ELEC-291-Dream-Team/Project-2-Tracking-Robot/doc/robot diagram/robot diagram.png

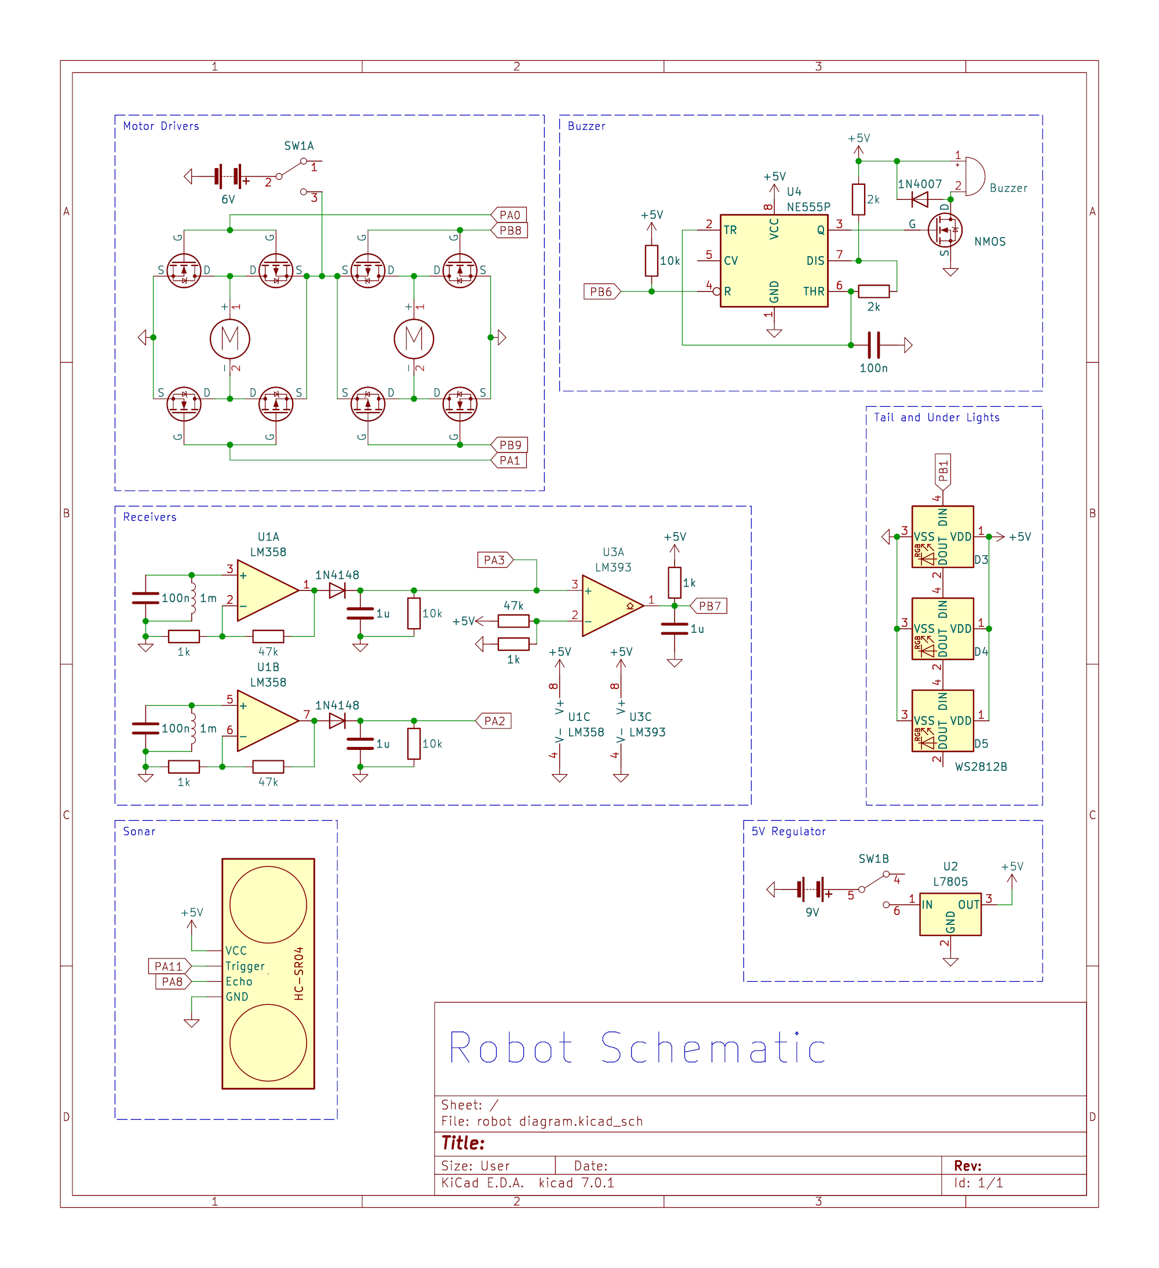
doc/robot diagram/robot diagram.png
