ELEC-291-Dream-Team/Project-2-Tracking-Robot/doc/robot diagram/robot diagram.kicad_pcb

## KiCad design hw/lux_meter.kicad_sch

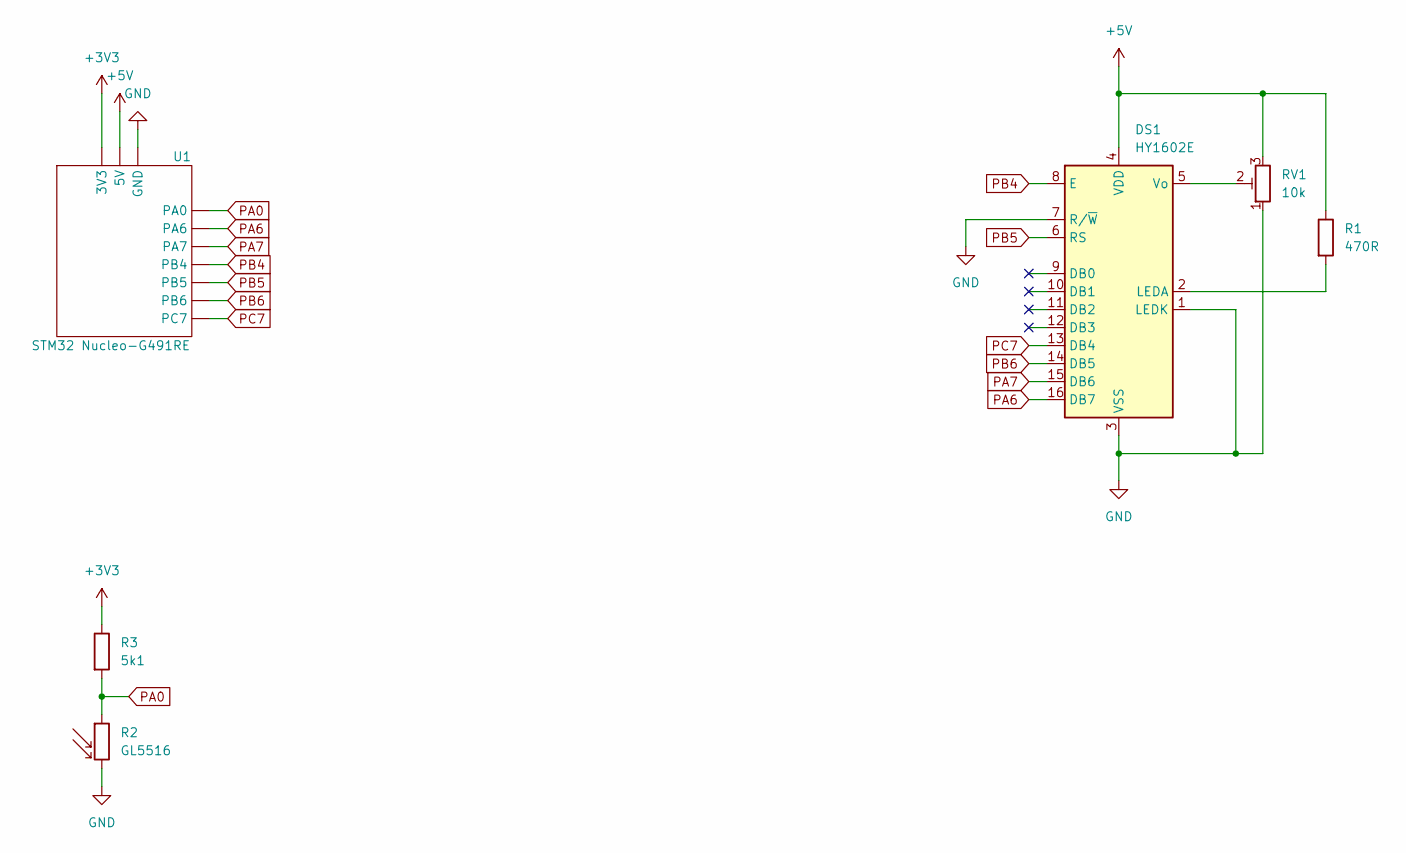
[picture p2: schematic lux_meter.kicad_sch]

Parts:
DS1: HY1602E
R1: 470R
R2: GL5516; R_LDR_5.1x4.3mm_P3.4mm_Vertical
R3: 5k1
RV1: 10k
U1: STM32 Nucleo-G491RE

Connections:
+3V3: R3.1, U1.
+5V: DS1.4 (VDD), R1.1, RV1.3, U1.
GND: DS1.1 (LEDK), DS1.3 (VSS), DS1.7 (R/~W), R2.2, RV1.1, U1.
unnamed: DS1.2 (LEDA), R1.2
unnamed: DS1.5 (Vo), RV1.2
PA0: R2.1, R3.2, U1.
PA6: DS1.16 (DB7), U1.
PA7: DS1.15 (DB6), U1.
PB4: DS1.8 (E), U1.
PB5: DS1.6 (RS), U1.
PB6: DS1.14 (DB5), U1.
PC7: DS1.13 (DB4), U1.
