ELEC-291-Dream-Team/Project-2-Tracking-Robot/src/robot/Core/Inc/main.h

#define LED_BUILTIN_Pin GPIO_PIN_13
#define LED_BUILTIN_GPIO_Port GPIOC
#define LEFT_MOTOR_B_Pin GPIO_PIN_0
#define LEFT_MOTOR_B_GPIO_Port GPIOA
#define LEFT_MOTOR_A_Pin GPIO_PIN_1
#define LEFT_MOTOR_A_GPIO_Port GPIOA
#define RIGHT_ADC_Pin GPIO_PIN_2
#define RIGHT_ADC_GPIO_Port GPIOA
#define LEFT_ADC_Pin GPIO_PIN_3
#define LEFT_ADC_GPIO_Port GPIOA
#define WS2812_PIN_Pin GPIO_PIN_1
#define WS2812_PIN_GPIO_Port GPIOB
#define SONAR_ECHO_Pin GPIO_PIN_8
#define SONAR_ECHO_GPIO_Port GPIOA
#define SONAR_TRIGGER_Pin GPIO_PIN_11
#define SONAR_TRIGGER_GPIO_Port GPIOA
#define BUZZER_PIN_Pin GPIO_PIN_6
#define BUZZER_PIN_GPIO_Port GPIOB
#define PULSE_IN_Pin GPIO_PIN_7
#define PULSE_IN_GPIO_Port GPIOB
#define RIGHT_MOTOR_B_Pin GPIO_PIN_8
#define RIGHT_MOTOR_B_GPIO_Port GPIOB
#define RIGHT_MOTOR_A_Pin GPIO_PIN_9
#define RIGHT_MOTOR_A_GPIO_Port GPIOB
#define TARGETADCLEFT 700
#define TARGETADCRIGHT 1050
#define DEADZONE 150
#define WS2812_HIGH_BIT 60
#define WS2812_LOW_BIT 30
#define LED_COUNT 3
#define LEFTADC ADCBuffer[0]
#define RIGHTADC ADCBuffer[1]
