ELEC-291-Dream-Team/Project-2-Tracking-Robot/src/robot/Core/Src/main.c

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
/* Includes ------------------------------------------------------------------*/
#include "main.h"

/* USER CODE BEGIN Includes */
#include <stdio.h>
#include <string.h>
#include <math.h>

/* USER CODE END Includes */

/* USER CODE BEGIN PD */
#define DEBUGGING
/* USER CODE END PD */

ADC_HandleTypeDef hadc1;
DMA_HandleTypeDef hdma_adc1;

TIM_HandleTypeDef htim1;
TIM_HandleTypeDef htim2;
TIM_HandleTypeDef htim3;
TIM_HandleTypeDef htim4;
DMA_HandleTypeDef hdma_tim3_ch4_up;

UART_HandleTypeDef huart1;

/* USER CODE BEGIN PV */
uint8_t WS2812Buffer[24 * LED_COUNT] = {0};
unsigned short LEDStep = 0;

uint16_t ADCBuffer[100];

char StringBuffer[100];

unsigned int TIM4LastFallingEdge;
unsigned int TIM4FallingEdge;
unsigned int ReceivedPeriodBuffer;
unsigned int ReceivedPeriod;

unsigned int SonarRisingEdge;
unsigned int SonarFallingEdge;
unsigned int SonarOverflowCount = 0;
long SonarPulse;
unsigned int SonarPulsePolarity = 1;

int Mode = 0; // 0 = track, 1 = controlled
/* USER CODE END PV */

void SystemClock_Config(void);
static void MX_GPIO_Init(void);
static void MX_DMA_Init(void);
static void MX_ADC1_Init(void);
static void MX_USART1_UART_Init(void);
static void MX_TIM4_Init(void);
static void MX_TIM3_Init(void);
static void MX_TIM1_Init(void);
static void MX_TIM2_Init(void);
/* USER CODE BEGIN PFP */
void SetColor(unsigned int index, unsigned short r, unsigned short g, unsigned short b);
void SetColorAll(unsigned short r, unsigned short g, unsigned short b);
void Rainbow(int length, float phase, float brightness);
void LeftMotor(int a, int b);
void RightMotor(int a, int b);
void SetTailLights(unsigned short r, unsigned short g, unsigned short b);
/* USER CODE END PFP */

/**
 * @brief  The application entry point.
 * @retval int
 */
int main(void)
{
    /* MCU Configuration--------------------------------------------------------*/

    /* Reset of all peripherals, Initializes the Flash interface and the Systick. */
    HAL_Init();

    /* Configure the system clock */
    SystemClock_Config();

    /* Initialize all configured peripherals */
    MX_GPIO_Init();
    MX_DMA_Init();
    MX_ADC1_Init();
    MX_USART1_UART_Init();
    MX_TIM4_Init();
    MX_TIM3_Init();
    MX_TIM1_Init();
    MX_TIM2_Init();
    /* USER CODE BEGIN 2 */
    HAL_ADC_Start_DMA(&hadc1, ADCBuffer, ARRAYLEN(ADCBuffer));

    LEFTSTOP();
    RIGHTSTOP();

    SetColorAll(0, 0, 0);

    sprintf(StringBuffer, "Start\r\n");
    HAL_UART_Transmit(&huart1, StringBuffer, strlen(StringBuffer), 10);
    /* USER CODE END 2 */

    /* Infinite loop */
    /* USER CODE BEGIN WHILE */
    while (1)
    {
        switch (Mode)
        {
        case 0: // tracking mode
            if (SonarPulse < 40)
            {
                HAL_GPIO_WritePin(BUZZER_PIN_GPIO_Port, BUZZER_PIN_Pin, 1);
            }
            else
            {
                HAL_GPIO_WritePin(BUZZER_PIN_GPIO_Port, BUZZER_PIN_Pin, 0);
            }
#ifdef DEBUGGING
            sprintf(StringBuffer, "Mode 0 ADC: %4d %4d Sonar: %d OV: %d\r\n", LEFTADC, RIGHTADC, SonarPulse, SonarOverflowCount);
            HAL_UART_Transmit(&huart1, StringBuffer, strlen(StringBuffer), 10);
            HAL_Delay(10);
#endif

            if (LEFTADC < TARGETADCLEFT - DEADZONE)
            {
                LEFTFORWARD();
            }
            else if (LEFTADC > TARGETADCLEFT + DEADZONE)
            {
                LEFTREVERSE();
            }
            else
            {
                LEFTSTOP();
            }

            if (RIGHTADC < TARGETADCRIGHT - DEADZONE)
            {
                RIGHTFORWARD();
            }
            else if (RIGHTADC > TARGETADCRIGHT + DEADZONE)
            {
                RIGHTREVERSE();
            }
            else
            {
                RIGHTSTOP();
            }
            break;
        case 1: // controlled mode
#ifdef DEBUGGING
            sprintf(StringBuffer, "Mode 1 PeriodB: %4d Period: %4d\r\n", ReceivedPeriodBuffer, ReceivedPeriod);
            HAL_UART_Transmit(&huart1, StringBuffer, strlen(StringBuffer), 10);
            HAL_Delay(10);
#endif
            ReceivedPeriod = ReceivedPeriodBuffer;
            if (COMPARE(ReceivedPeriod, 600, 25)) // forward
            {
                if (SonarPulse > 30)
                {
                    LEFTFORWARD();
                    RIGHTFORWARD();
                    SetTailLights(0, 0, 0);
                    HAL_GPIO_WritePin(BUZZER_PIN_GPIO_Port, BUZZER_PIN_Pin, 0);
                }
                else
                {
                    SetTailLights(30, 0, 0);
                    HAL_GPIO_WritePin(BUZZER_PIN_GPIO_Port, BUZZER_PIN_Pin, 1);
                }
            }
            else if (COMPARE(ReceivedPeriod, 650, 25)) // forward right
            {
                LEFTFORWARD();
                RIGHTSTOP();
                SetTailLights(0, 0, 0);
                HAL_GPIO_WritePin(BUZZER_PIN_GPIO_Port, BUZZER_PIN_Pin, 0);
            }
            else if (COMPARE(ReceivedPeriod, 700, 25)) // right
            {
                LEFTFORWARD();
                RIGHTREVERSE();
                SetTailLights(0, 0, 0);
                HAL_GPIO_WritePin(BUZZER_PIN_GPIO_Port, BUZZER_PIN_Pin, 0);
            }
            else if (COMPARE(ReceivedPeriod, 750, 25)) // reverse right
            {
                LEFTSTOP();
                RIGHTREVERSE();
                SetTailLights(10, 10, 10);
                HAL_GPIO_WritePin(BUZZER_PIN_GPIO_Port, BUZZER_PIN_Pin, 1);
            }
            else if (COMPARE(ReceivedPeriod, 800, 25)) // reverse
            {
                LEFTREVERSE();
                RIGHTREVERSE();
                SetTailLights(10, 10, 10);
                HAL_GPIO_WritePin(BUZZER_PIN_GPIO_Port, BUZZER_PIN_Pin, 1);
            }
            else if (COMPARE(ReceivedPeriod, 850, 25)) // reverse left
            {
                LEFTREVERSE();
                RIGHTSTOP();
                SetTailLights(10, 10, 10);
                HAL_GPIO_WritePin(BUZZER_PIN_GPIO_Port, BUZZER_PIN_Pin, 1);
            }
            else if (COMPARE(ReceivedPeriod, 900, 25)) // left
            {
                LEFTREVERSE();
                RIGHTFORWARD();
                SetTailLights(0, 0, 0);
                HAL_GPIO_WritePin(BUZZER_PIN_GPIO_Port, BUZZER_PIN_Pin, 0);
            }
            else if (COMPARE(ReceivedPeriod, 950, 25)) // forward left
            {
                LEFTSTOP();
                RIGHTFORWARD();
                SetTailLights(0, 0, 0);
                HAL_GPIO_WritePin(BUZZER_PIN_GPIO_Port, BUZZER_PIN_Pin, 0);
            }
            else // stop
            {
                LEFTSTOP();
                RIGHTSTOP();
                SetTailLights(30, 0, 0);
                HAL_GPIO_WritePin(BUZZER_PIN_GPIO_Port, BUZZER_PIN_Pin, 0);
            }
            break;
        default:
            break;
        }

        /* USER CODE END WHILE */

        /* USER CODE BEGIN 3 */
    }
    /* USER CODE END 3 */
}

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
/* USER CODE BEGIN 4 */

void SetColor(unsigned int index, unsigned short r, unsigned short g, unsigned short b)
{
    for (int mask = 0b10000000, i = 0; mask > 0; mask >>= 1, i++)
    {
        if (g & mask)
            WS2812Buffer[index * 24 + i] = WS2812_HIGH_BIT;
        else
            WS2812Buffer[index * 24 + i] = WS2812_LOW_BIT;
        if (r & mask)
            WS2812Buffer[index * 24 + 8 + i] = WS2812_HIGH_BIT;
        else
            WS2812Buffer[index * 24 + 8 + i] = WS2812_LOW_BIT;
        if (b & mask)
            WS2812Buffer[index * 24 + 16 + i] = WS2812_HIGH_BIT;
        else
            WS2812Buffer[index * 24 + 16 + i] = WS2812_LOW_BIT;
    }
}

void SetColorAll(unsigned short r, unsigned short g, unsigned short b)
{
    for (int i = 0; i < LED_COUNT; i++)
    {
        SetColor(i, r, g, b);
    }
}

void Rainbow(int length, float phase, float brightness)
{
    for (int i = 0; i < LED_COUNT; i++)
    {
        SetColor(i,
                 (unsigned short)(brightness * (cos(2 * M_PI * (phase + (float)i / length)) * 0xff + 0x7f)),
                 (unsigned short)(brightness * (cos(2 * M_PI * (phase + (float)i / length - 1.0 / 3)) * 0xff + 0x7f)),
                 (unsigned short)(brightness * (cos(2 * M_PI * (phase + (float)i / length - 2.0 / 3)) * 0xff + 0x7f)));
    }
}

void SetTailLights(unsigned short r, unsigned short g, unsigned short b)
{
    SetColor(0, r, g, b);
    SetColor(1, r, g, b);
}

void LeftMotor(int a, int b)
{
    HAL_GPIO_WritePin(LEFT_MOTOR_A_GPIO_Port, LEFT_MOTOR_A_Pin, a);
    HAL_GPIO_WritePin(LEFT_MOTOR_B_GPIO_Port, LEFT_MOTOR_B_Pin, b);
}

void RightMotor(int a, int b)
{
    HAL_GPIO_WritePin(RIGHT_MOTOR_A_GPIO_Port, RIGHT_MOTOR_A_Pin, a);
    HAL_GPIO_WritePin(RIGHT_MOTOR_B_GPIO_Port, RIGHT_MOTOR_B_Pin, b);
}

void HAL_TIM_PWM_PulseFinishedCallback(TIM_HandleTypeDef *htim)
{
    if (htim == &htim3)
    {
        __HAL_TIM_SetCompare(&htim3, TIM_CHANNEL_4, 0);
        HAL_TIM_PWM_Stop_DMA(&htim3, TIM_CHANNEL_4);
    }
}

void HAL_TIM_PeriodElapsedCallback(TIM_HandleTypeDef *htim)
{
    if (htim == &htim2)
    {
#ifdef DEBUGGING
        // sprintf(StringBuffer, "tim2 overflows\r\n");
        // HAL_UART_Transmit(&huart1, StringBuffer, strlen(StringBuffer), 10);
#endif
        if (HAL_GPIO_ReadPin(PULSE_IN_GPIO_Port, PULSE_IN_Pin) == 1)
            Mode = 0;
    }
    if (htim == &htim1)
    {
#ifdef DEBUGGING
        // sprintf(StringBuffer, "tim1 overflows %d\r\n", __HAL_TIM_GetCounter(&htim1));
        // HAL_UART_Transmit(&huart1, StringBuffer, strlen(StringBuffer), 10);
#endif
        SonarOverflowCount++;
        LEDStep += 1;
        switch (Mode)
        {
        case 0:
            SetColorAll(
                (unsigned short)(0.15 * (cos(2 * M_PI * (LEDStep / 255.0)) * 0xff + 0x7f)),
                (unsigned short)(0.15 * (cos(2 * M_PI * (LEDStep / 255.0 - 1.0 / 3)) * 0xff + 0x7f)),
                (unsigned short)(0.15 * (cos(2 * M_PI * (LEDStep / 255.0 - 2.0 / 3)) * 0xff + 0x7f)));
            break;
        case 1:
            SetColor(2,
                     (unsigned short)(0.15 * (cos(2 * M_PI * (LEDStep / 255.0)) * 0xff + 0x7f)),
                     (unsigned short)(0.15 * (cos(2 * M_PI * (LEDStep / 255.0 - 1.0 / 3)) * 0xff + 0x7f)),
                     (unsigned short)(0.15 * (cos(2 * M_PI * (LEDStep / 255.0 - 2.0 / 3)) * 0xff + 0x7f)));
            break;
        default:
            break;
        }
        HAL_TIM_PWM_Start_DMA(&htim3, TIM_CHANNEL_4, (uint32_t *)WS2812Buffer, ARRAYLEN(WS2812Buffer));
    }
}

void HAL_TIM_IC_CaptureCallback(TIM_HandleTypeDef *htim)
{
    if (htim == &htim1)
    {
        if (htim->Channel == HAL_TIM_ACTIVE_CHANNEL_1)
        {
            if (SonarPulsePolarity == 1)
            {
                SonarRisingEdge = HAL_TIM_ReadCapturedValue(&htim1, TIM_CHANNEL_1);
                SonarPulsePolarity = 0;
                SonarOverflowCount = 0;
                __HAL_TIM_SET_CAPTUREPOLARITY(&htim1, TIM_CHANNEL_1, TIM_INPUTCHANNELPOLARITY_FALLING);
#ifdef DEBUGGING
                HAL_GPIO_WritePin(LED_BUILTIN_GPIO_Port, LED_BUILTIN_Pin, 1);
#endif
            }
            else
            {
                SonarFallingEdge = HAL_TIM_ReadCapturedValue(&htim1, TIM_CHANNEL_1);
                SonarPulse = SonarOverflowCount * 2000 + SonarFallingEdge - SonarRisingEdge;
                SonarPulsePolarity = 1;
                __HAL_TIM_SET_CAPTUREPOLARITY(&htim1, TIM_CHANNEL_1, TIM_INPUTCHANNELPOLARITY_RISING);
#ifdef DEBUGGING
                HAL_GPIO_WritePin(LED_BUILTIN_GPIO_Port, LED_BUILTIN_Pin, 0);
#endif
            }
        }
    }
    if (htim == &htim4)
    {
        if (htim->Channel == HAL_TIM_ACTIVE_CHANNEL_2) // falling edge
        {
            TIM4FallingEdge = HAL_TIM_ReadCapturedValue(&htim4, TIM_CHANNEL_2);
            ReceivedPeriodBuffer = TIM4FallingEdge - TIM4LastFallingEdge;
            TIM4LastFallingEdge = TIM4FallingEdge;

#ifdef DEBUGGING
            // sprintf(StringBuffer, "tim4 ch2 %4d %4d\r\n", ReceivedPeriodBuffer, TIM4FallingEdge);
            // HAL_UART_Transmit(&huart1, StringBuffer, strlen(StringBuffer), 10);
#endif
            Mode = 1;
            __HAL_TIM_SetCounter(&htim2, 0);
        }
    }
}

// void HAL_ADC_ConvHalfCpltCallback(ADC_HandleTypeDef *hadc)
// {
// }

// void HAL_ADC_ConvCpltCallback(ADC_HandleTypeDef *hadc)
// {
// }

/* USER CODE END 4 */
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
