ELEC-291-Dream-Team/Project-2-Tracking-Robot/(commit log)

2023-03-23 adc, rgb, motor control
2023-03-28 PWM input
2023-04-05 tweaked rgb, pwm to period encoding
2023-04-05 tweaked rgb, pwm to period encoding, sonar sensor
2023-04-12 robot's schematic
    [robot diagram.kicad_pcb, robot diagram.kicad_sch]
2023-04-13 robot diagram
    [robot diagram.kicad_sch]
