ELEC-291-Dream-Team/Project-2-Tracking-Robot/(notices)

Notices in the files:
src/robot/Core/Src/main.c:
Copyright (c) 2023 STMicroelectronics.
All rights reserved.
This software is licensed under terms that can be found in the LICENSE file
